genglinWang/Smart-Calendar-Clock/README.md

# Smart-Calendar-Clock:open_mouth:

This project is one part of Open-Innovation-1(开放性创新实践) for Chongxin Collage(崇新学堂), School of Information Science and Engineering, Shandong university, China. I'm happy to provide my solution on how to establish and create a smart bluetooth calendar clock based on STC89C52 microcontrollor.

It is a simple but meaningful system design project about sensors, microcontrollors and IOT. If you are interested, please refer to [report.pdf](https://github.com/genglinWang/Smart-Calendar-Clock/blob/main/Report.pdf) for more details, and feel free to contact me, discuss about the project and pick faults:dizzy_face:.

## System Overview
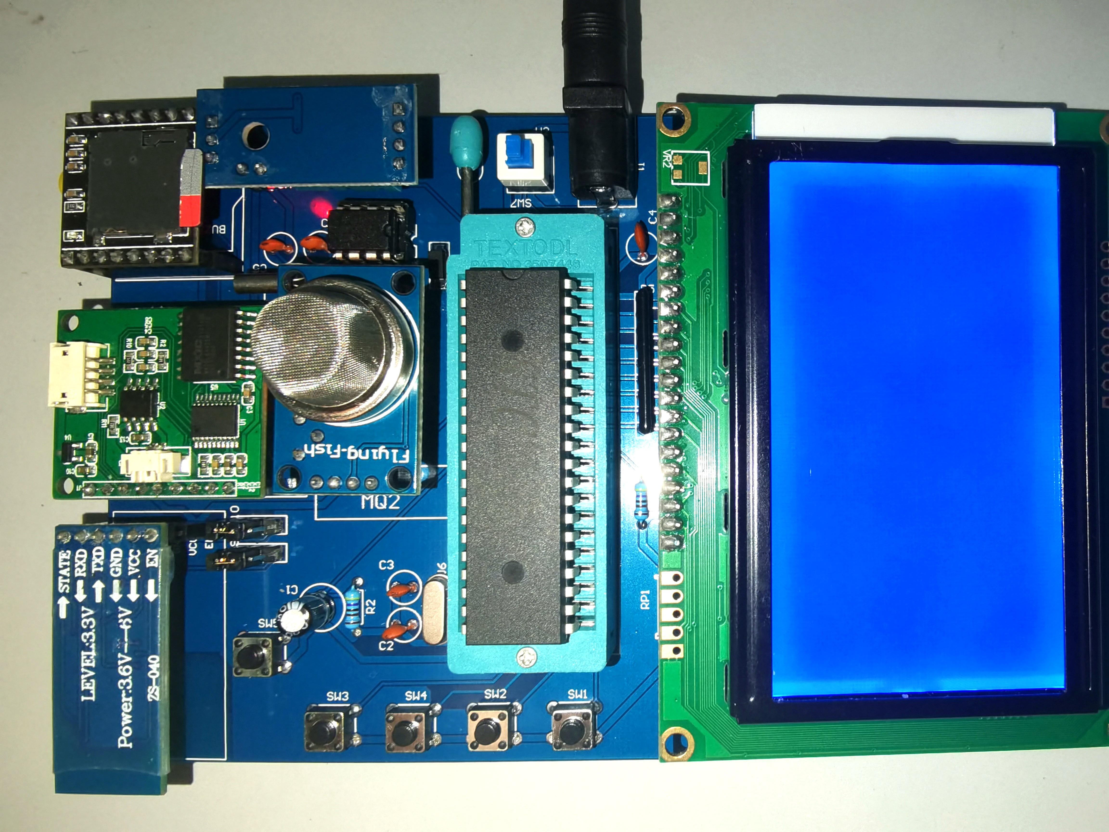
[picture p1: docs/img/demo.jpg]


## Demo: Displaying time, temperature and humidity
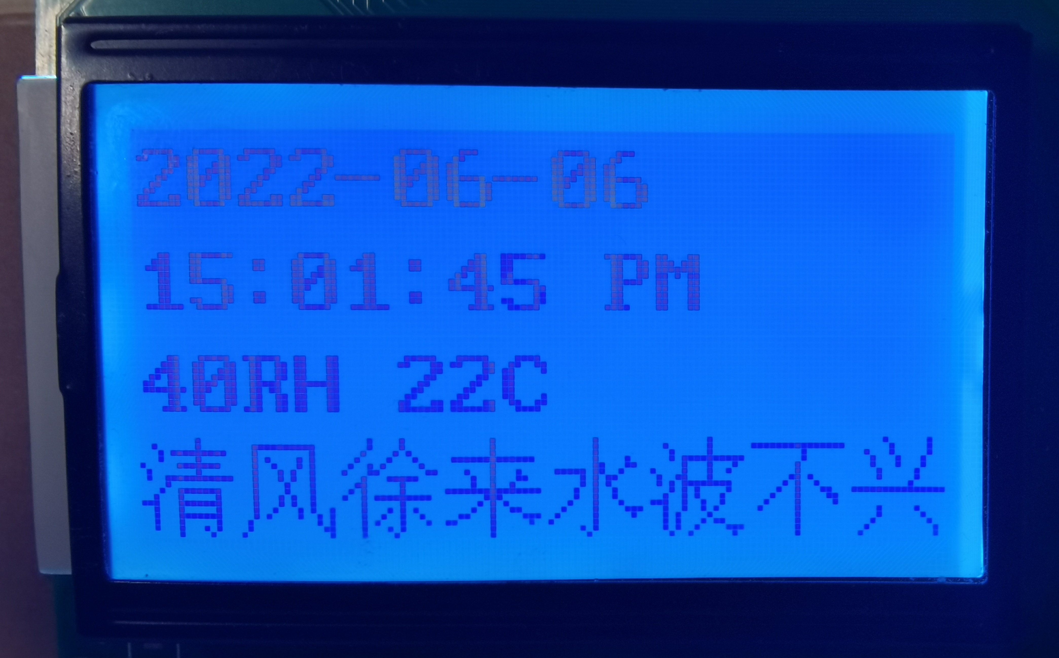
[picture p2: docs/img/demo1.jpg]


# To-do list

## Basic
- [x] Display Current year, month, day, hour, minute and second 
- [x] Set year, month, day, hour, minute, second via button matrix
- [x] Set and display AM and PM
- [x] Display Chinese lunar year, month, day and Chinese 24 solar terms
- [x] Set alarm clock time and alarm clock music
- [x] Detect and display temperature and humidity
## Advanced
- [x] Select alarm clock music (using TF card to store music data)
- [x] Mobile phones connect to the system through Bluetooth, and APP can complete the basic settings above
- [x] Get online weather forecast by mobile phone APP, then transmit and display the weather on LCD
- [x] Fire detection and alarm via text message

# Hardware

## Sensors and Modules
* DHT11: Temperature and humidity
* MQ-2: Smoke concentration
* JQ8900-16P: Music player
* LCD12864: Liquid Crystal Display
* TTS: Text-to-speech
* HC-05: Bluetooth

## Schematic
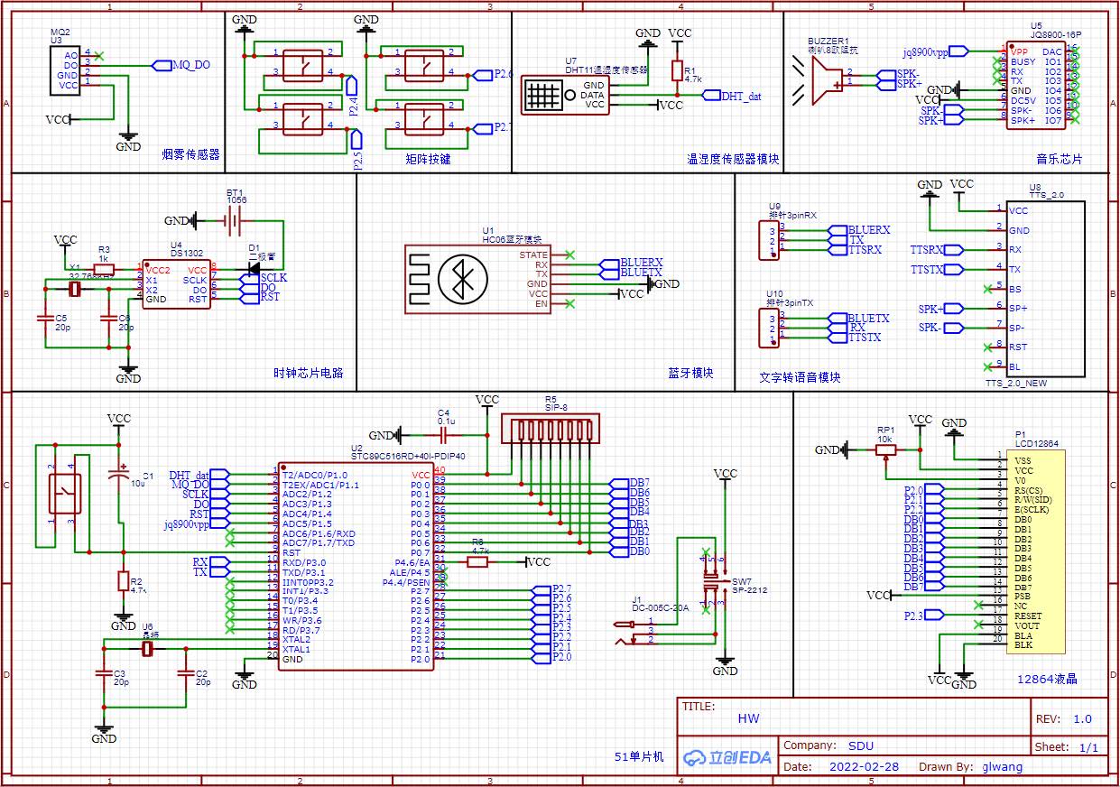
[picture p3: docs/img/Schematic.jpg]

The schematic is designed by https://lceda.cn/. It can help developers find the proper schematics and corresponding PCB Packages of their favourite sensors and modules.

Pls note that my PCB board is powered by common 5V chargers, i.e. mobile phone chargers, and USB-DC005 cable. Since DC005 is uncommon, you can change the power interface into type-c, micro or USB, just using your phone charger and cable to power the PCB board (except for Apple users:joy:).

My schematic was selected and shown in the teaching PowerPoint of Open-Innovation-1 in 2023 Spring.:stuck_out_tongue_closed_eyes::heart:

## PCB Layout
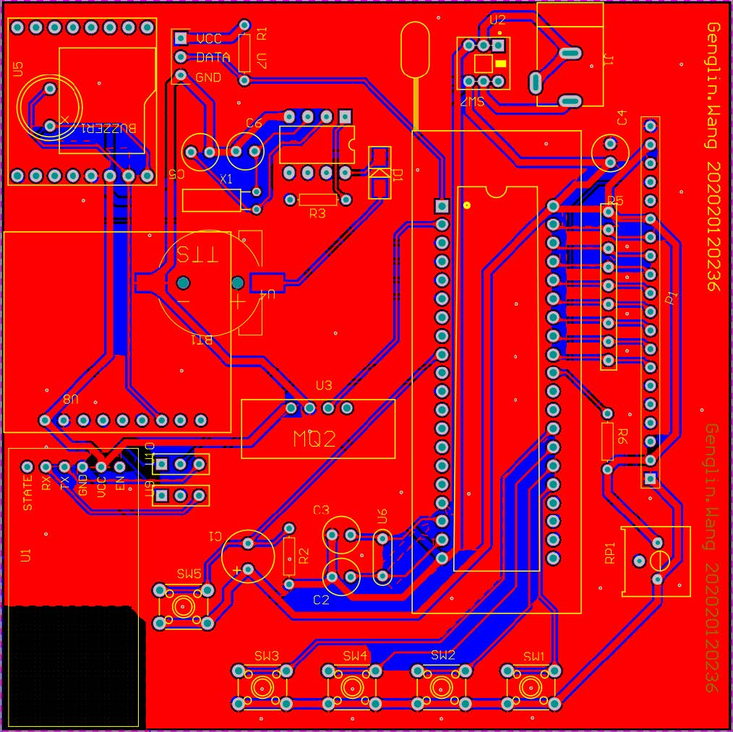
[picture p4: docs/img/PCBup.jpg]

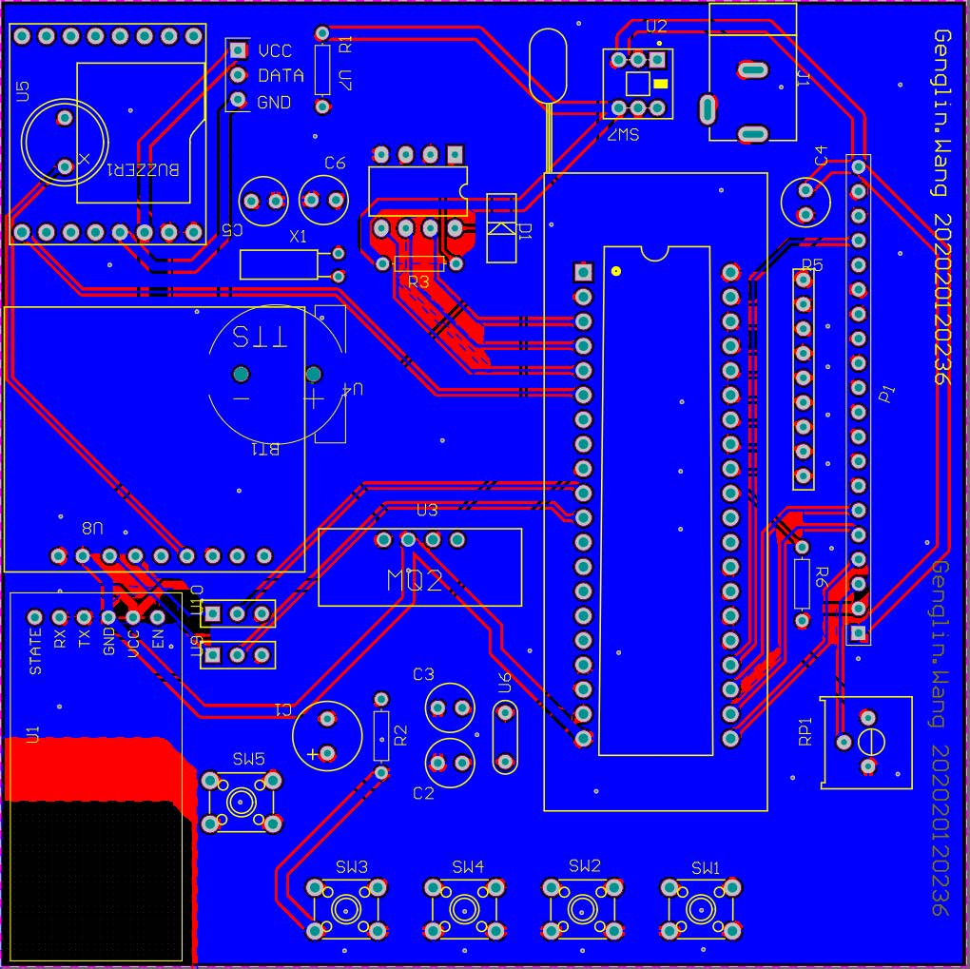
[picture p5: docs/img/PCBdown.jpg]

All PCB layouts are developped by Altium-Desinger.

# Software
You can refer to [src](https://github.com/genglinWang/Smart-Calendar-Clock/tree/main/src) for drivers of sensors and modules. All the source code is developped by keil.

# APP
You can refer to [Appinventor](https://github.com/genglinWang/Smart-Calendar-Clock/tree/main/Appinventor) for .aia file in App inventor, which is a graphic app programming website.
