genglinWang/Smart-Calendar-Clock/(list of files, cad)

Other CAD files:
docs/JQ8900-16P/串口测试程序/APP/output/Main.obj
src/Objects/main.obj
docs/DHT11/DHT11 51测试程序/STARTUP.OBJ
docs/JQ8900-16P/串口测试程序/APP/output/UART.obj
docs/LCD12864/13液晶12864显示/7920_580b.OBJ
src/Objects/dht11.obj
docs/DHT11/DHT11 51测试程序/Lesson1.OBJ
src/Objects/lunar.obj
src/Objects/STARTUP.obj
src/Objects/jq8900.obj
src/Objects/ds1302.obj
src/Objects/keyscan.obj
src/Objects/Text2Voice.obj
src/Objects/bluetooth.obj
src/Objects/lcd12864new.obj
src/Objects/12864.obj
