genglinWang/Smart-Calendar-Clock/docs/TTS/1电脑串口调试工具/串口调试助手调试TTS套件.pdf

1 使用准备：

准备材料 | 数量 | 说明
TTS 语音播报套件 | 1 | 推荐用套件，若只有模块，需自行接好喇叭和线
USB 转串口线 | 1 | 推荐 PL2303，不推荐用 CH340（因其波特率不 准），电脑装好对应的驱动

2 连接方法：

如图，PL2303 线的 5V TX RX GND（通常对应颜色红绿白黑）对应连接模块的 5V RX TX GND（对应红黄白黑）

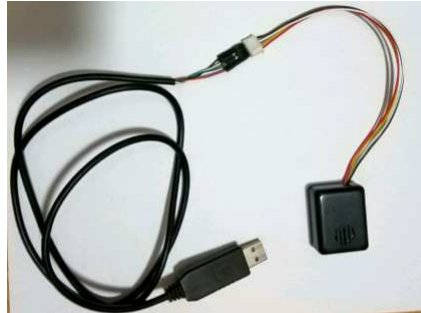
[picture p6: figure]

3 用电脑串口调试助手进行测试（本处推荐 SSCOM）

1） | 插入 USB 串口线到电脑，cnTTS 套件会播报一声提示音。
2） | 打开 SSCOM，选择电脑上对应的串口号，波特率等参数为 9600,8，N，1，打 开串口

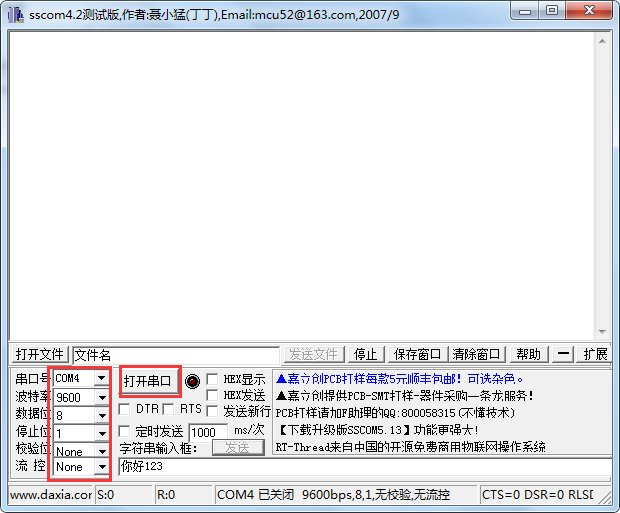
[picture p7: figure]

3） 发送区域输入测试内容，点击发送，TTS 语音播报套件会播出您输入的内容。

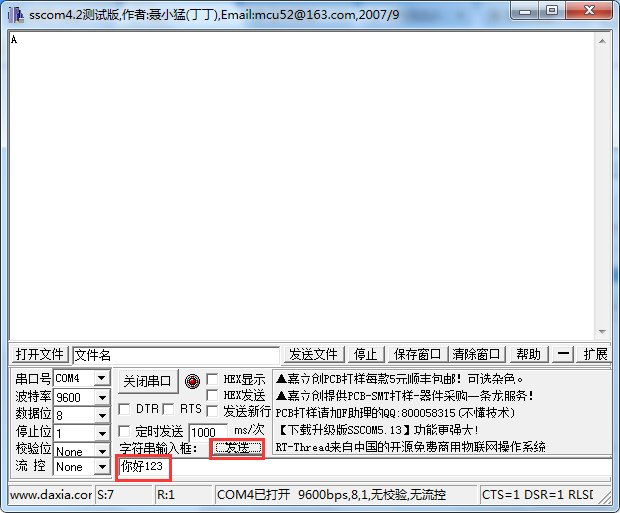
[picture p8: figure]

4） 能正确播出语音，即完成测试。

常见问题：

1） | 上电（插入 USB 线时）没有提示音：极可能是电源供电不正常，排查电源线是 否接反，电压是否为 5V？可以用万用表测量。
2） | 发送字符不能正确播报：极可能是收发线接反，交叉一下收发线测试一下。如 果是播报的是乱码，则可能是串口线的波特率有误差(比如 CH340)，建议更换 串口线。
