genglinWang/Smart-Calendar-Clock/docs/LCD12864/QC12864B.pdf

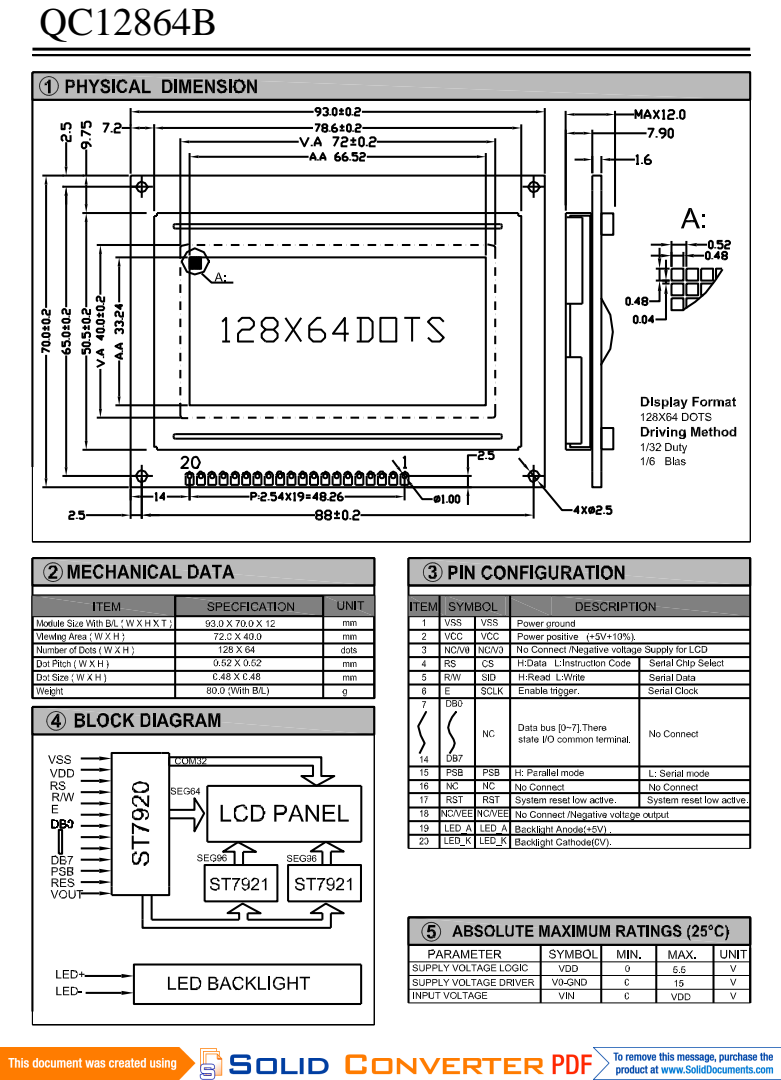
[picture p9: page 1]
