genglinWang/Smart-Calendar-Clock/docs/DHT11/DHT11模块--.pdf

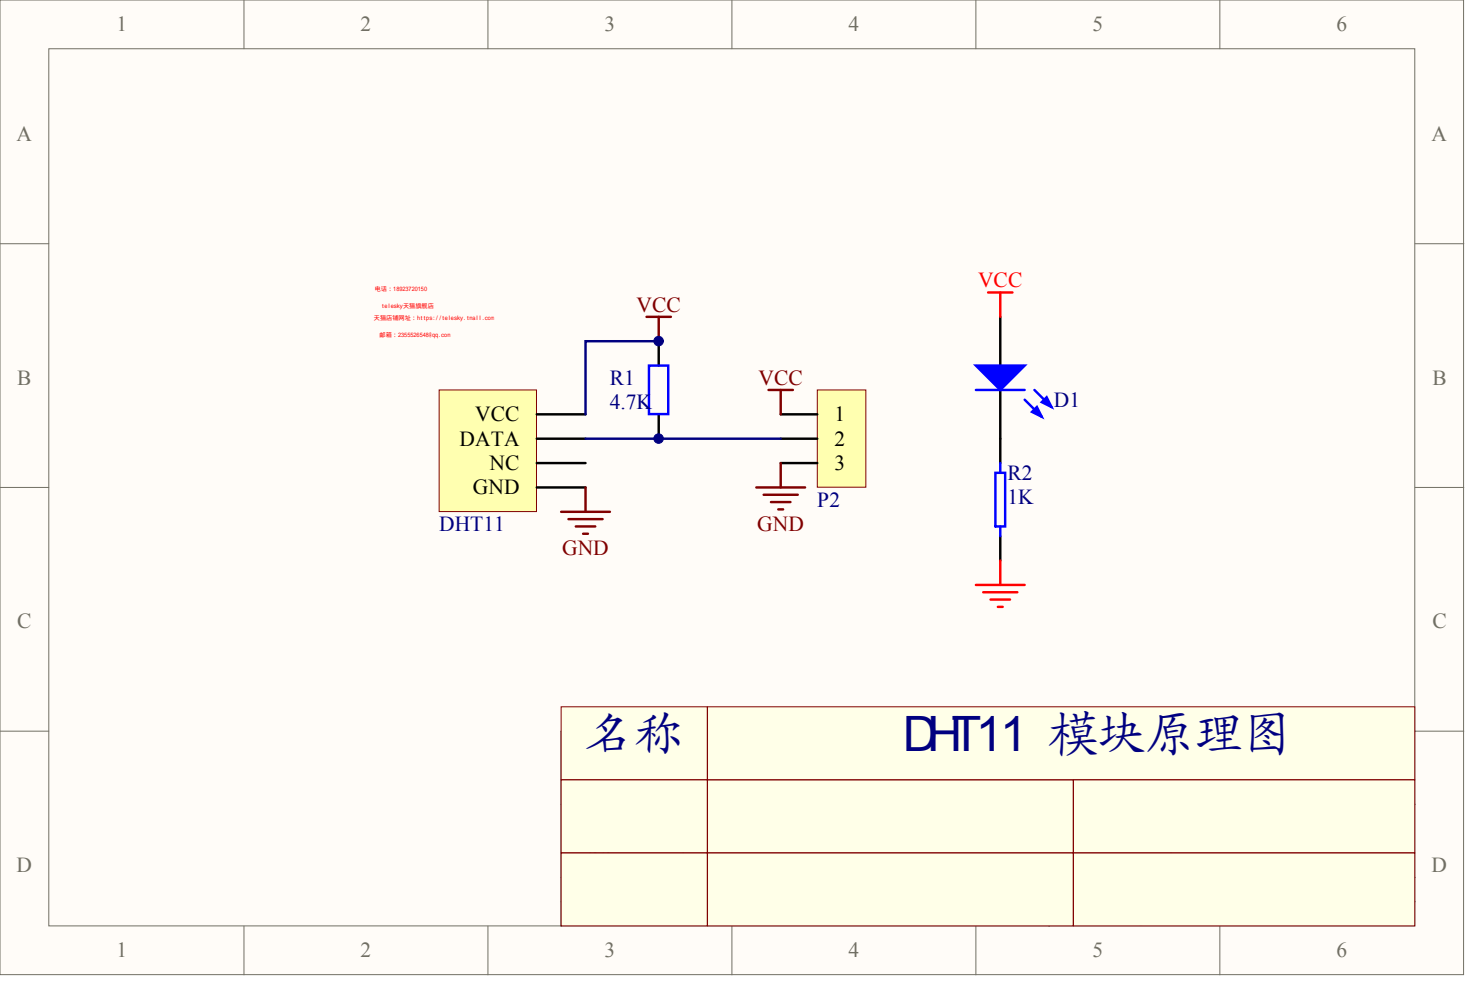
[picture p10: page 1]
Date:; 2012-2-14 File:; \..\DHT11; .SchDoc; Drawn By:; DHT11 模块原理图 P0D101 P0D102; P0DHT1101

天猫店铺网址：https://telesky.tmall.com

邮箱：2355526548@qq.com
