genglinWang/Smart-Calendar-Clock/(list of files, drawings)

Other design files:
PCB-layout/PCB-V1.0.pcbdoc
