genglinWang/Smart-Calendar-Clock/src/tts.h

//#ifndef __TTS_H_
//#define __TTS_H_

////---包含头文件---//
//#include <reg52.h>
//#include <string.h>
//#include <stdio.h>
////---重定义关键词---//
//#ifndef uchar
//#define uchar unsigned char
//#endif

//#ifndef uint 
//#define uint unsigned int
//#endif

////---定义jq8900使用的IO口---//


//////---定义全局函数---//
//void Uart_Init(void);
//char putchar(char c);
//void Delay_ms(int x);

//////---加入全局变量--//
//extern voice[16];
//#endif
